SasikaA073/EDP-iCliq-program/Images/Loading animations/download/IMG_7490.gif

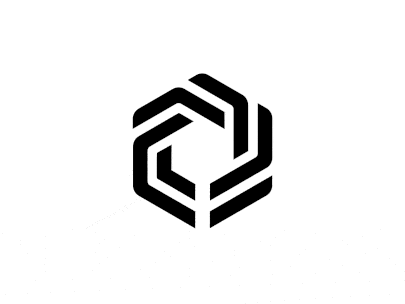
Images/Loading animations/download/IMG_7490.gif
