SasikaA073/EDP-iCliq-program/Images/Loading animations/download/IMG_7491.gif

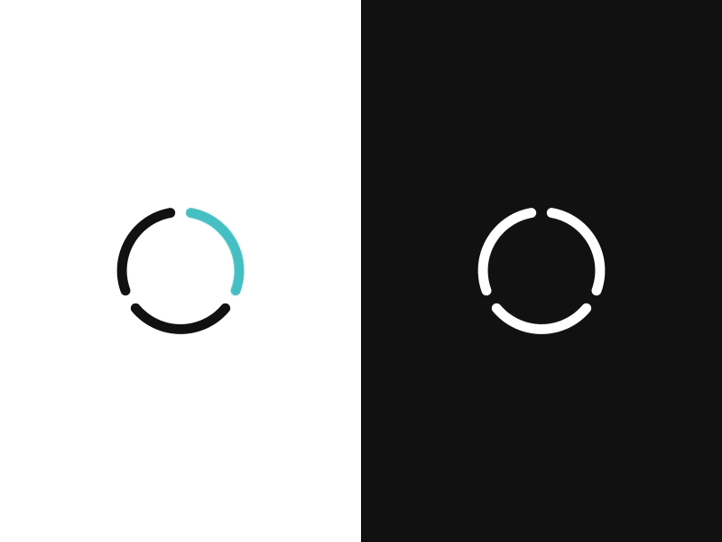
Images/Loading animations/download/IMG_7491.gif
