SasikaA073/EDP-iCliq-program/Images/Loading animations/download/IMG_7492.jpeg

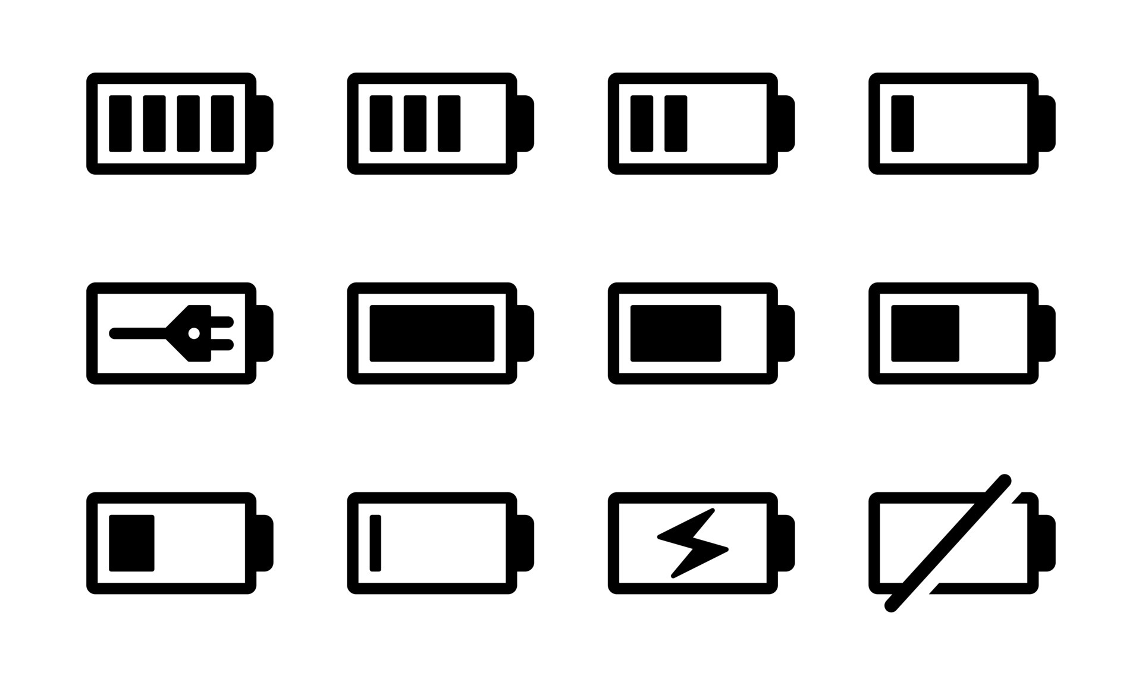
Images/Loading animations/download/IMG_7492.jpeg
