SasikaA073/EDP-iCliq-program/Reports and Presentations/iCliQ_manual.pdf

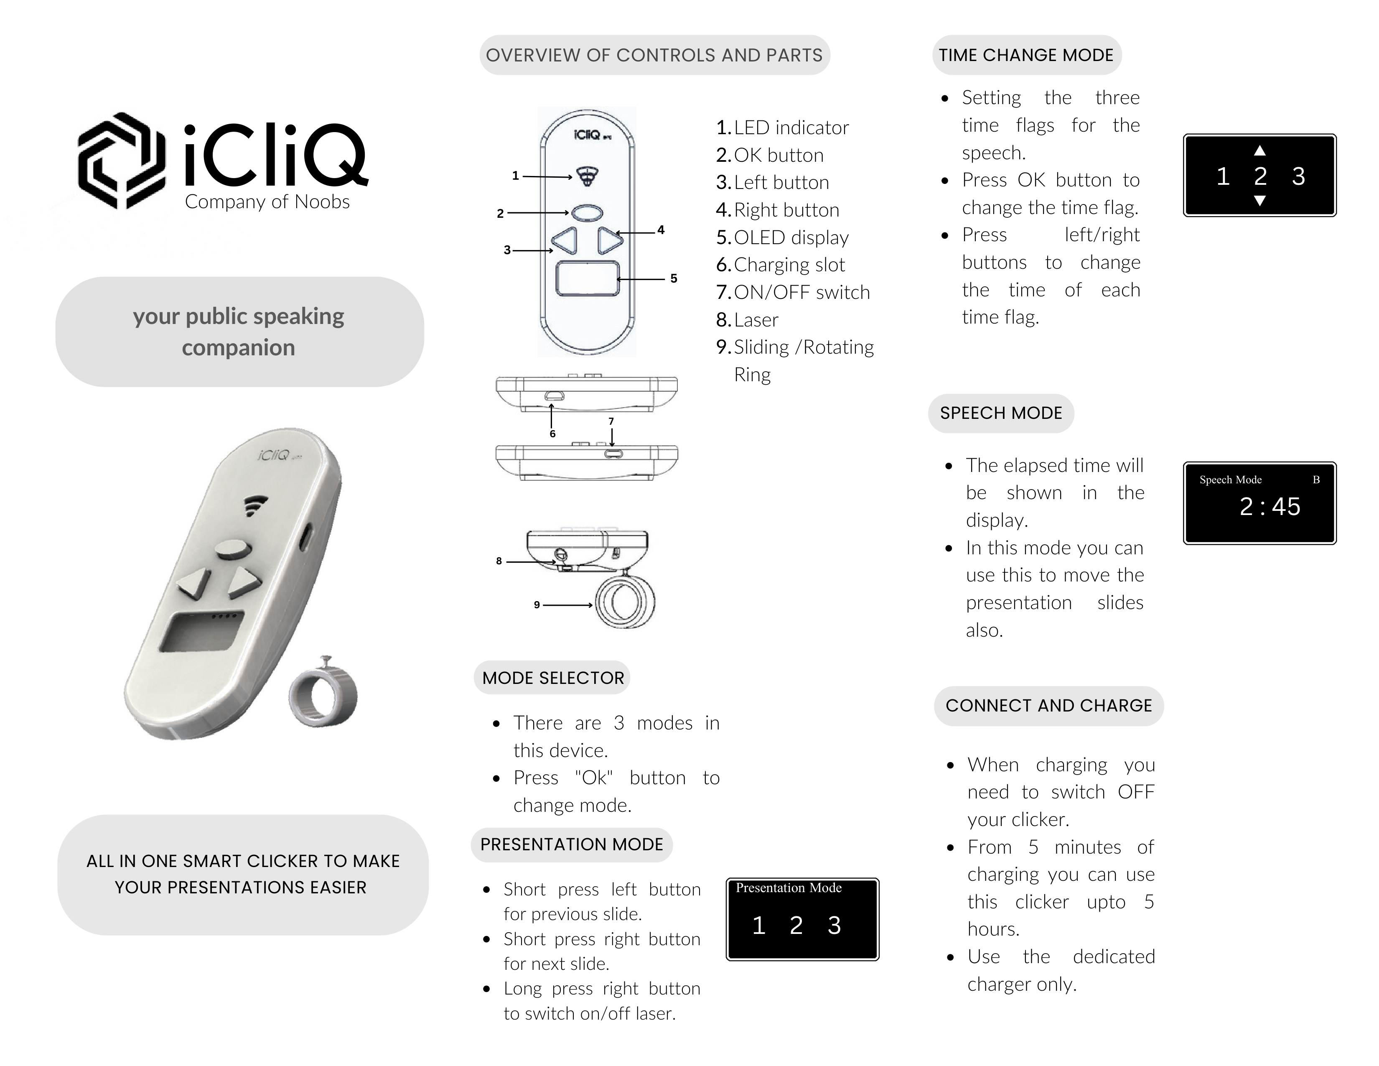
[picture p15: page 1]
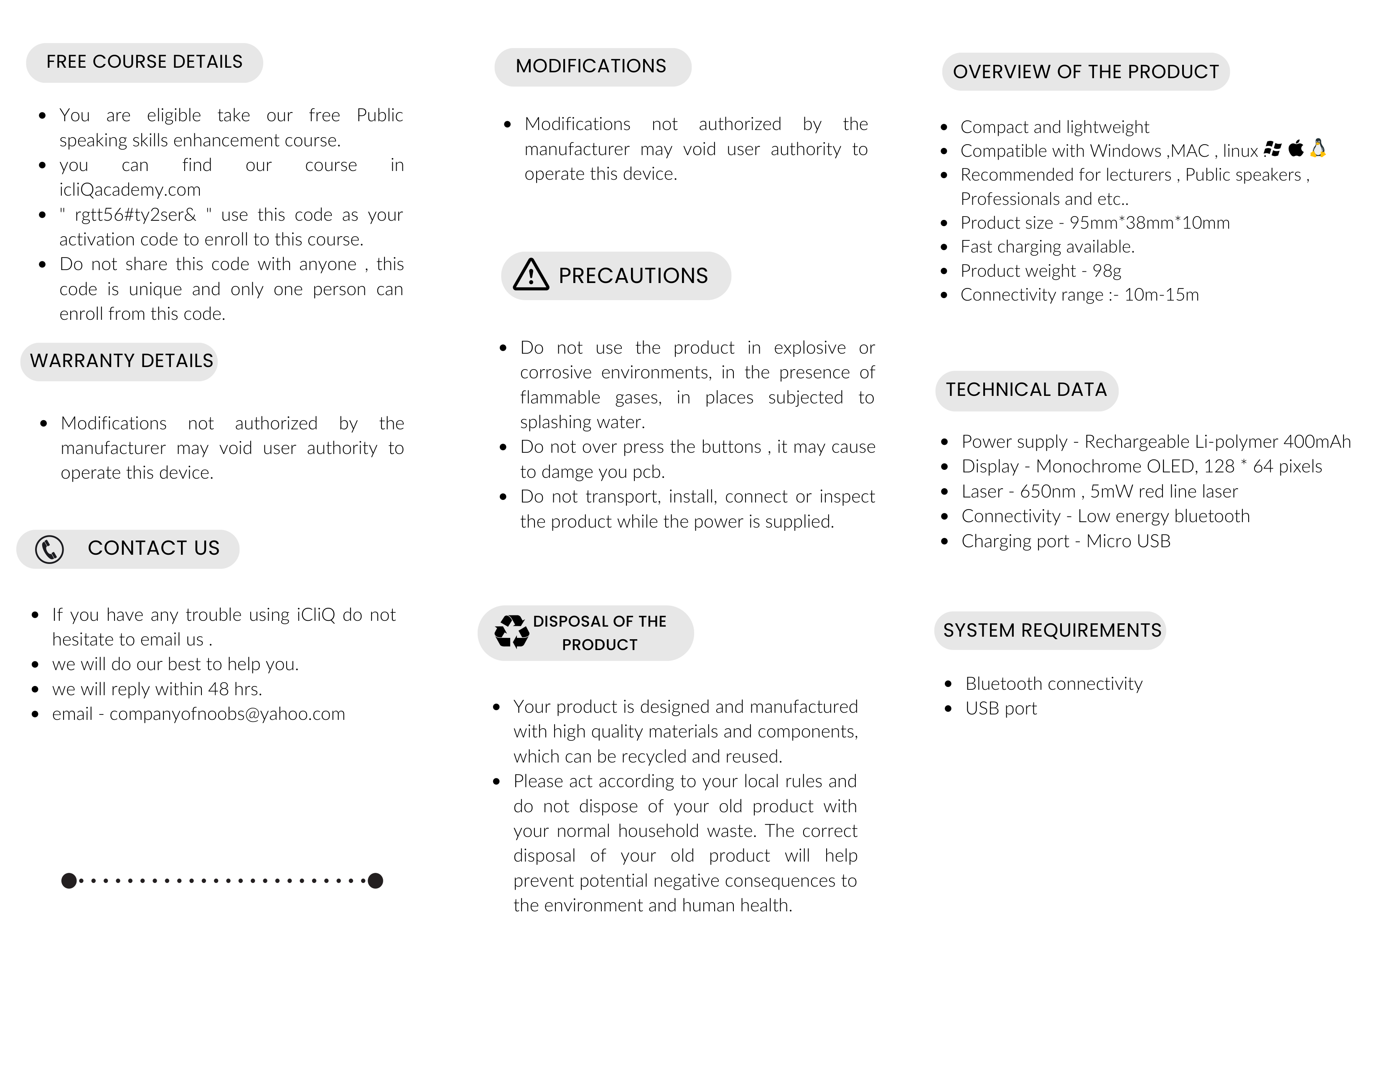
[picture p16: page 2]
