SasikaA073/EDP-iCliq-program/(list of files, drawings)

Other design files:
Schematic/iCliq V1 schematic/iCliQ_v1 - Copy.PrjPcb
Schematic/iCliq V1 schematic/iCliQ_v1.SchDoc
