SasikaA073/EDP-iCliq-program/(commit log)

2023-07-18 added schematic design
    [iCliQ_v1 - Copy.PrjPcb, iCliQ_v1.SchDoc]
2023-07-18 ✅ push button counter ,⬆️&⬇️added
2023-07-23 timer value up and down working
2023-07-23 up and down buttons working , now can change the timer value
    [iCliQ_v1 - Copy.PrjPcb, iCliQ_v1.SchDoc]
2023-08-01 added battery status
2023-08-01 buttons are working correctly
2023-08-01 updated the PCB code
2023-08-03 can change time flags; updated pcb code;
2023-08-03 update on latest change; laser working
2023-08-04 changed folder structure
    [iCliQ_v1 - Copy.PrjPcb, iCliQ_v1.SchDoc]
2023-08-04 used millis(); timer count up not working accordinly
    [icliq_pcb.h, main_program_for_pcb.ino]
2023-08-12 ✅ Refactored code & Restructured dir
    [iCliQ_v1 - Copy.PrjPcb, iCliQ_v1.SchDoc]
2024-01-07 💡RGB LED: added dual core processing
